rjobidon/esp8266-andon/(commit log)

2017-11-15 Added circuit diagram
2017-11-24 Added titles and bill of material
2020-03-29 update voltage regulator to LD1117AV33
